ak66666/ThumbsUpV13_Omron/Photos/rev.0/IMG_20260822_193503417.jpg

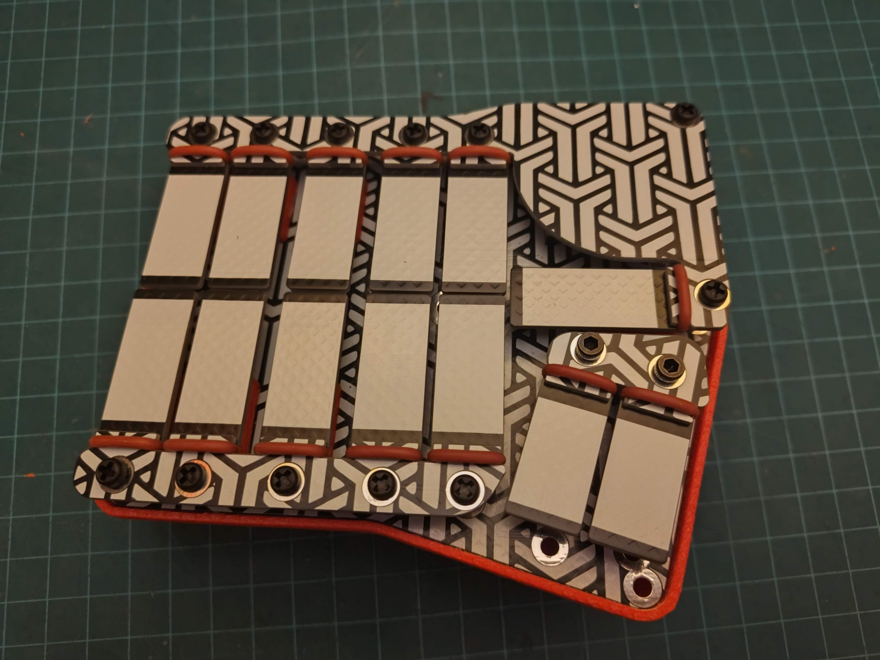
Photos/rev.0/IMG_20260822_193503417.jpg
