ak66666/ThumbsUpV13_Omron/Photos/rev.0/IMG_20260822_193524192_HDR.jpg

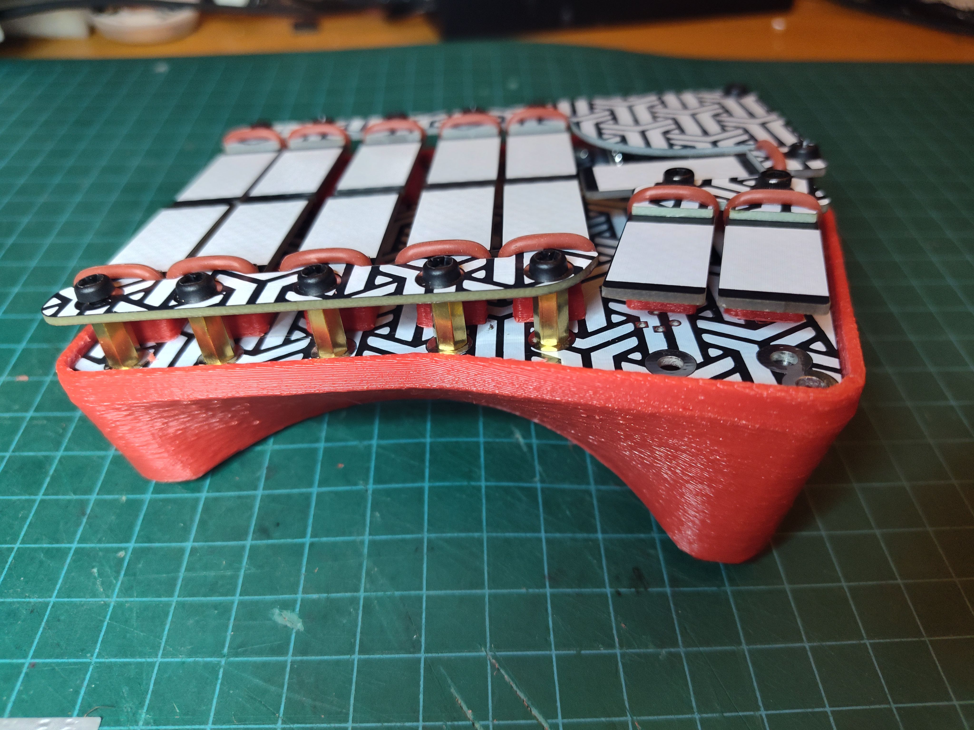
Photos/rev.0/IMG_20260822_193524192_HDR.jpg
