ak66666/ThumbsUpV13_Omron/Photos/rev.0/IMG_20260822_193620206.jpg

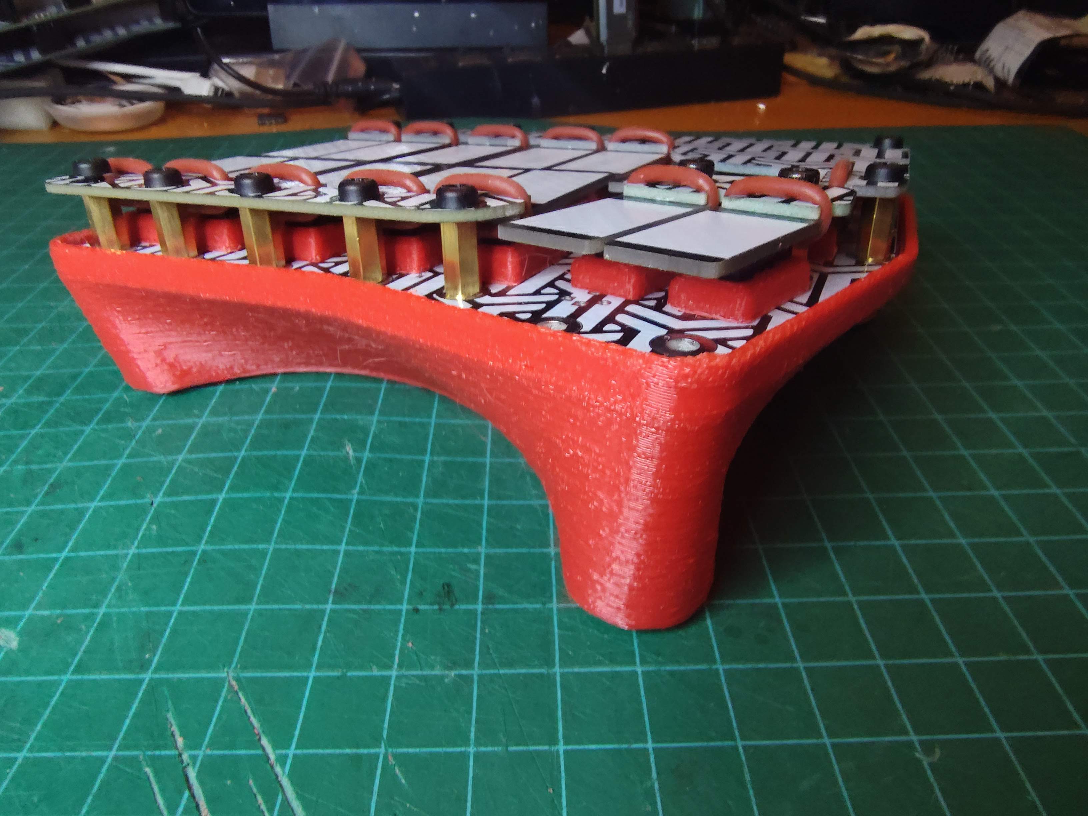
Photos/rev.0/IMG_20260822_193620206.jpg
