ak66666/ThumbsUpV13_Omron/Photos/rev.0/IMG_20260822_220550309_HDR.jpg

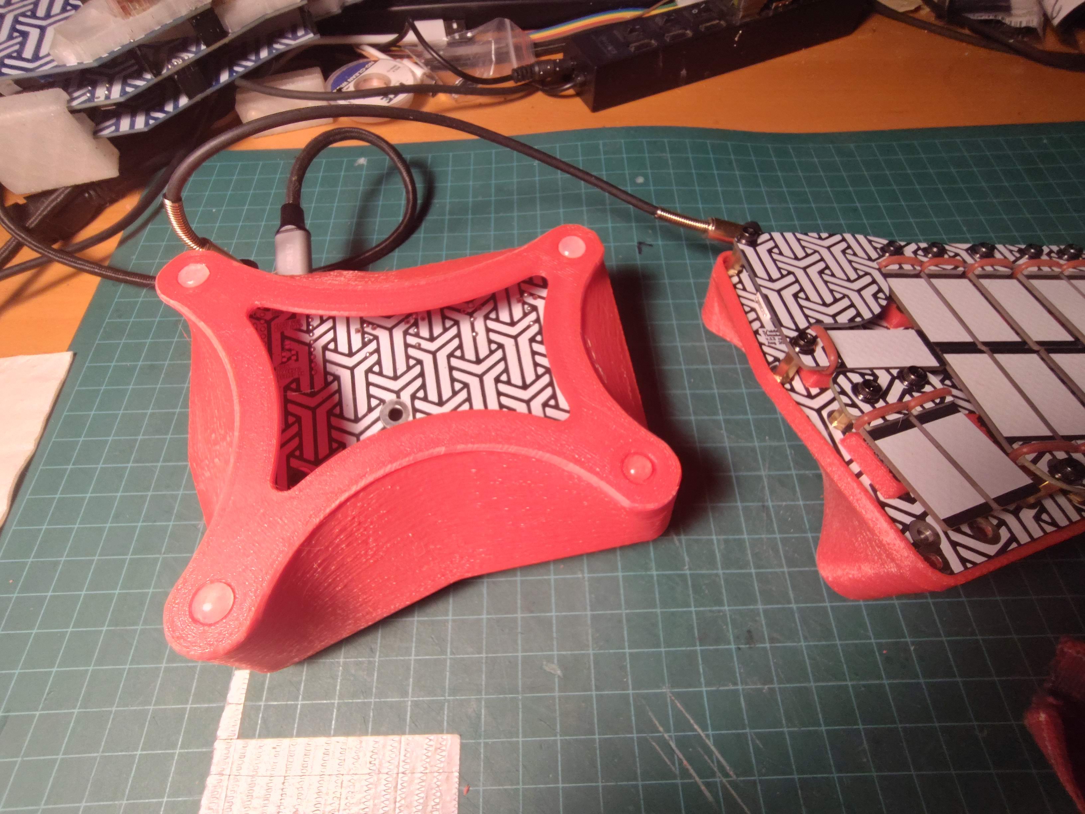
Photos/rev.0/IMG_20260822_220550309_HDR.jpg
