ak66666/ThumbsUpV13_Omron/Silkscreens/Pattern.png

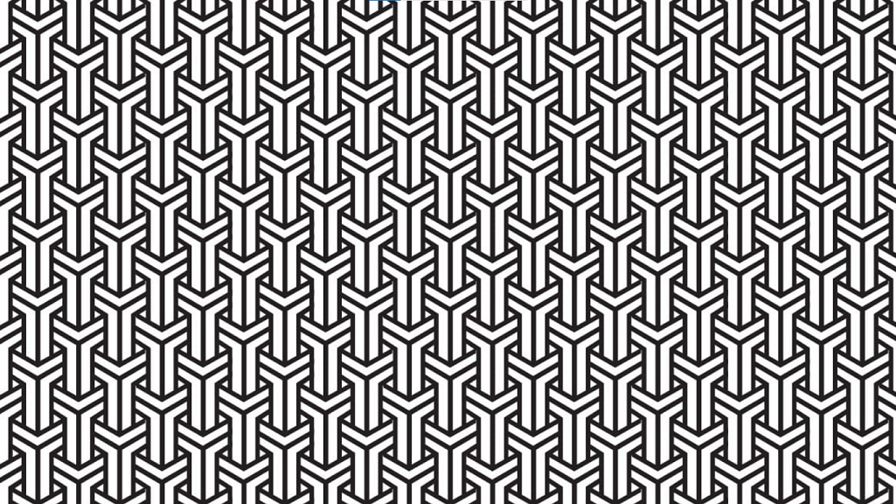
Silkscreens/Pattern.png
