ak66666/ThumbsUpV13_Omron/Silkscreens/QWERTY.png

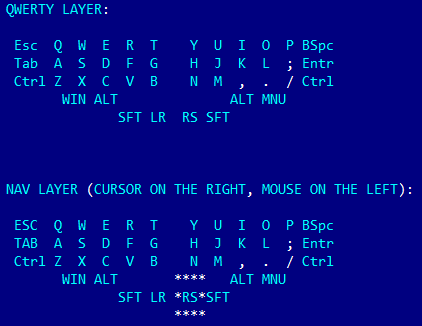
Silkscreens/QWERTY.png
