ak66666/ThumbsUpV13_Omron/3D Printed/Switch Raiser 6x6 Tilted.stl

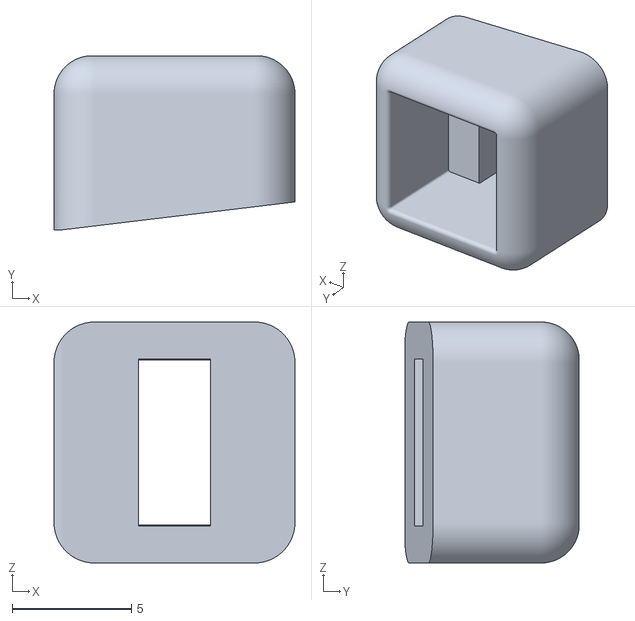
[picture p37: CAD file, 2026-08-06]
3D Printed/Switch Raiser 6x6 Tilted.stl
10.1 x 7.29 x 10.1
