ak66666/ThumbsUpV13_Omron/3D Printed/v13 Rev.0/Case Curvy Right.stl

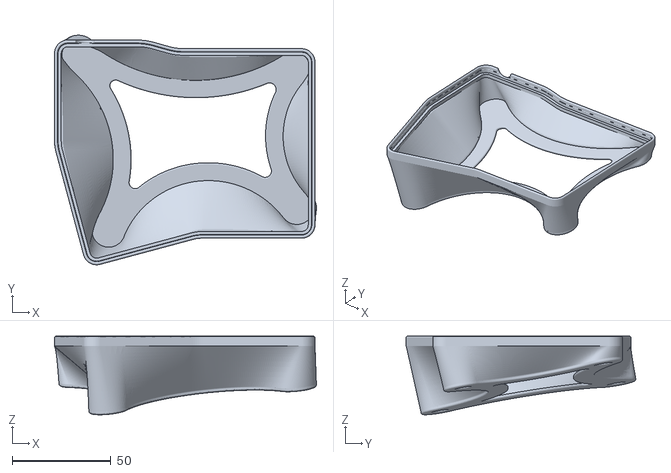
[picture p38: CAD file, 2026-08-23]
3D Printed/v13 Rev.0/Case Curvy Right.stl
132.4 x 116.0 x 39.7
