ak66666/ThumbsUpV13_Omron/STX-3501-3N/3D/STX-3501-3N.stp

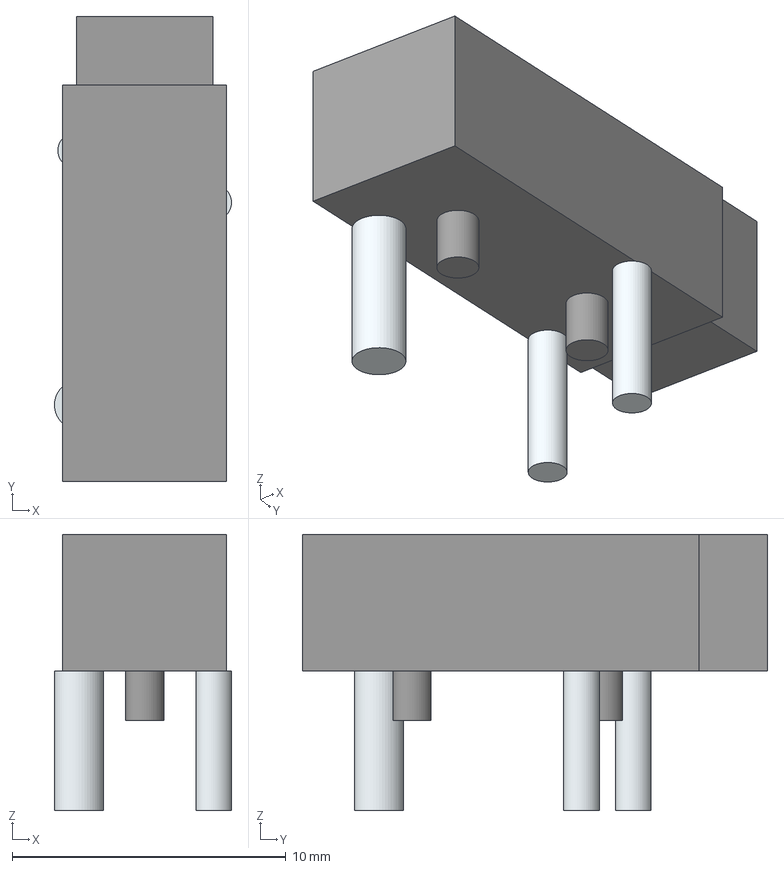
[picture p39: CAD file, 2026-08-06]
STX-3501-3N/3D/STX-3501-3N.stp
6.47 x 17.0 x 10.1 mm
Lugs
Leads
