ak66666/ThumbsUpV13_Omron/W25Q128JVSIM/3D/W25Q128JVSIM.stp

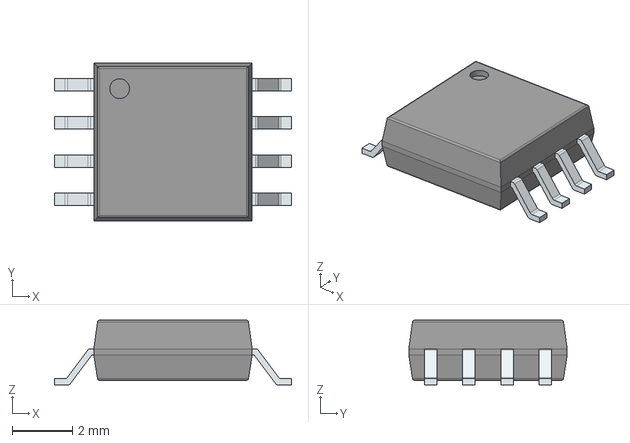
[picture p40: CAD file, 2026-08-06]
W25Q128JVSIM/3D/W25Q128JVSIM.stp
7.90 x 5.28 x 2.16 mm
PinsArrayLR
