ak66666/ThumbsUpV13_Omron/3D Printed/Base.stl

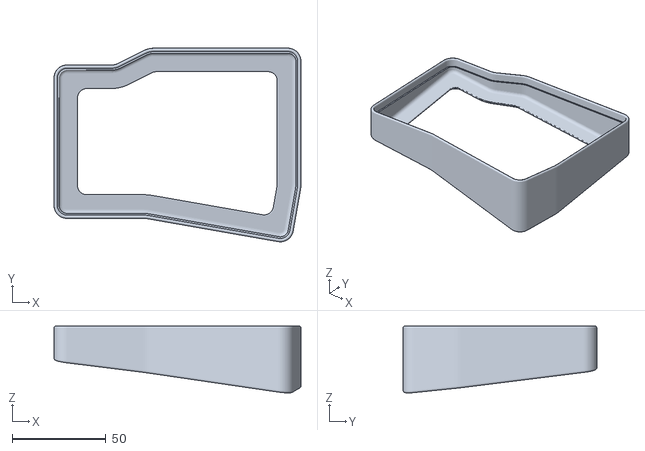
[picture p41: CAD file, 2026-08-06]
3D Printed/Base.stl
132.0 x 103.5 x 35.7
