ak66666/ThumbsUpV13_Omron/3D Printed/v13 Rev.0/Case Straight Right.stl

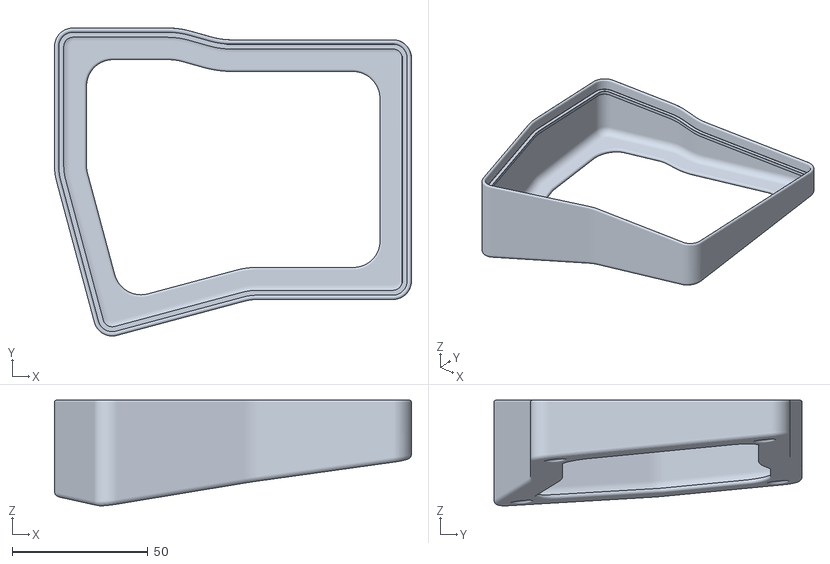
[picture p42: CAD file, 2026-08-22]
3D Printed/v13 Rev.0/Case Straight Right.stl
131.6 x 113.6 x 39.0
