ak66666/ThumbsUpV13_Omron/3D Printed/Switch Raiser Omron Tilted.stl

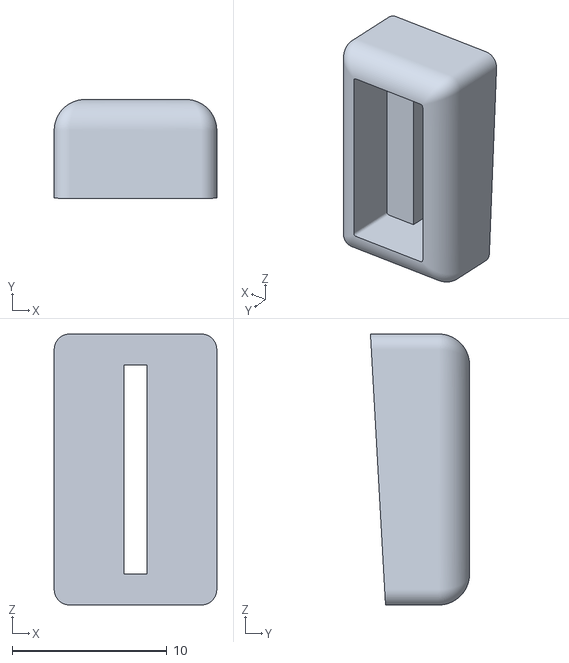
[picture p43: CAD file, 2026-08-06]
3D Printed/Switch Raiser Omron Tilted.stl
10.5 x 6.40 x 17.5
