ak66666/ThumbsUpV13_Omron/3D Printed/v13 Rev.0/Bottom Plate.step

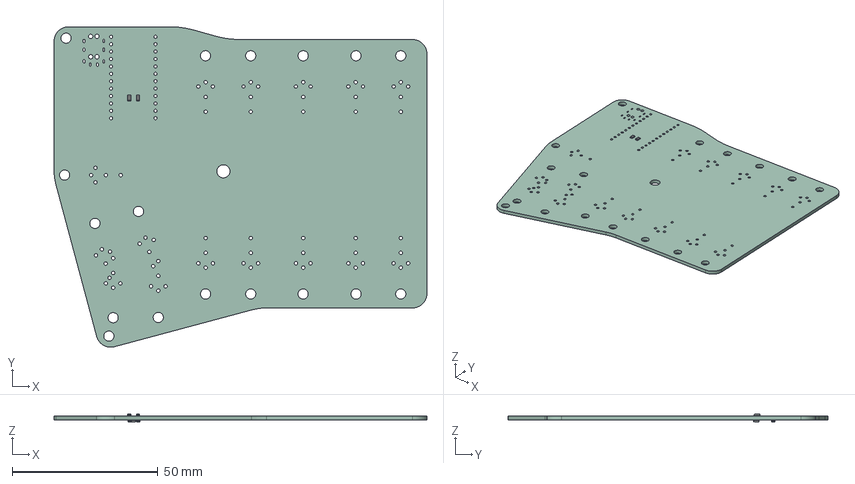
[picture p44: CAD file, 2026-08-22]
3D Printed/v13 Rev.0/Bottom Plate.step
128.0 x 110.0 x 2.58 mm
R_0805_2012Metric x 5
ThumbsUp_PCB
