ak66666/ThumbsUpV13_Omron/3D Printed/Switch Raiser 6x6.stl

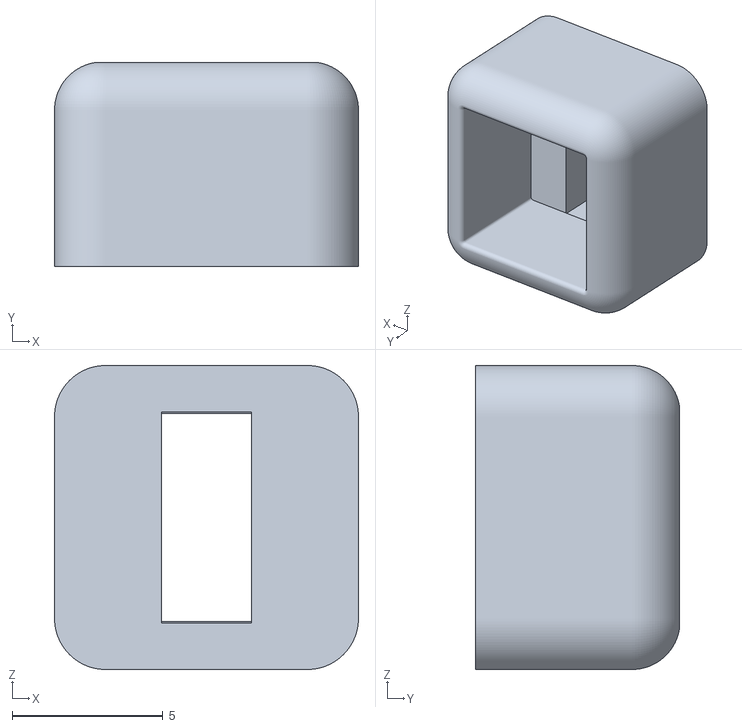
[picture p45: CAD file, 2026-08-06]
3D Printed/Switch Raiser 6x6.stl
10.1 x 6.79 x 10.1
