ak66666/ThumbsUpV13_Omron/3D Printed/v13 Rev.0/Heel Left.stl

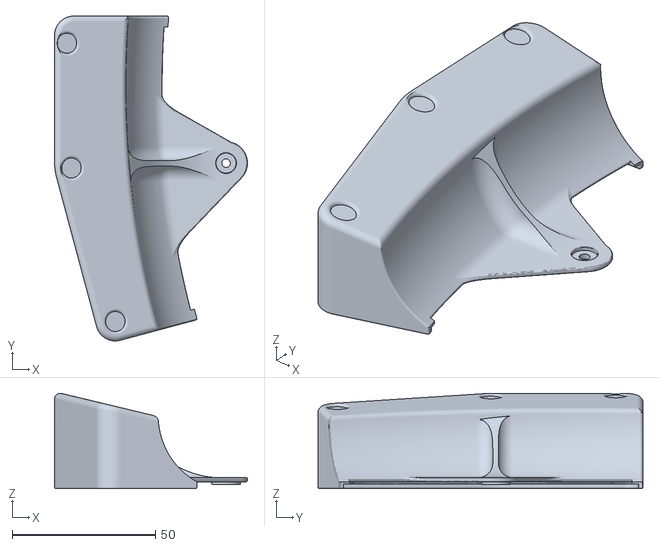
[picture p46: CAD file, 2026-08-06]
3D Printed/v13 Rev.0/Heel Left.stl
67.5 x 113.6 x 33.4
