ak66666/ThumbsUpV13_Omron/105450-0101/3D/105450-0101.stp

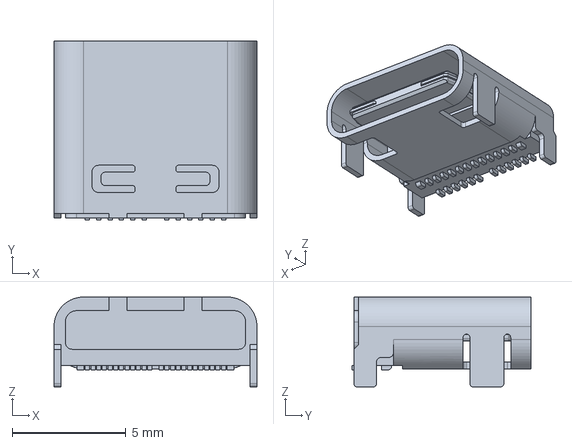
[picture p47: CAD file, 2026-08-06]
105450-0101/3D/105450-0101.stp
8.94 x 7.90 x 3.96 mm
