ak66666/ThumbsUpV13_Omron/Molex 52559-1233/52559-1233/3D/52559-1233.stp

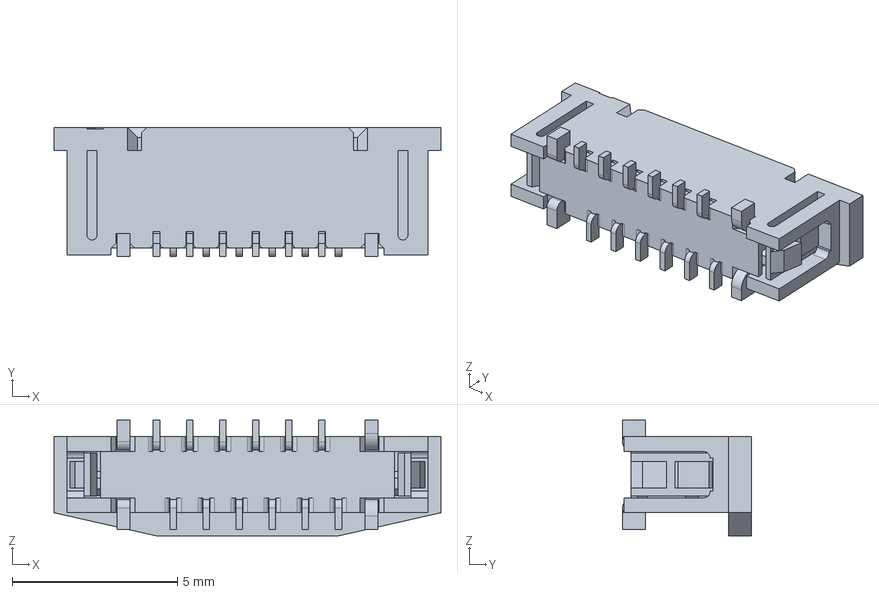
[picture p48: CAD file, 2026-08-06]
Molex 52559-1233/52559-1233/3D/52559-1233.stp
11.7 x 3.90 x 3.50 mm
