ak66666/ThumbsUpV13_Omron/(list of files, cad)

Other CAD files:
EVQ-P7B01P/Allegro/evqp7b01p.psm
EVQ-P7B01P/DEHDL/evq_p7b01p/chips/chips.prt
Molex 52559-1233/52559-1233/Allegro/525591233.psm
Molex 52559-1233/52559-1233/DEHDL/52559_1233/chips/chips.prt
STX-3501-3N/Allegro/stx35013n.psm
STX-3501-3N/DEHDL/stx_3501_3n/chips/chips.prt
TL1016AAF220QG/Allegro/tl1016aaf220qg.psm
TL1016AAF220QG/DEHDL/tl1016aaf220qg/chips/chips.prt
W25Q128JVSIM/Allegro/soic127p790x216-8n.psm
W25Q128JVSIM/DEHDL/w25q128jvsim/chips/chips.prt
