ak66666/ThumbsUpV13_Omron/(list of files, drawings)

Other design files:
EVQ-P7B01P/Altium/EVQ-P7B01P.SchLib
EVQ-P7B01P/Altium/EVQP7B01P.PcbLib
STX-3501-3N/Altium/STX35013N.PcbLib
STX-3501-3N/Altium/STX-3501-3N.SchLib
TL1016AAF220QG/Altium/TL1016AAF220QG.PcbLib
TL1016AAF220QG/Altium/TL1016AAF220QG.SchLib
W25Q128JVSIM/Altium/SOIC127P790X216-8N.PcbLib
W25Q128JVSIM/Altium/W25Q128JVSIM.SchLib
