ak66666/ThumbsUpV13_Omron/ThumbsUp.kicad_pcb

## KiCad design ThumbsUp.kicad_pcb (2026-11-06)

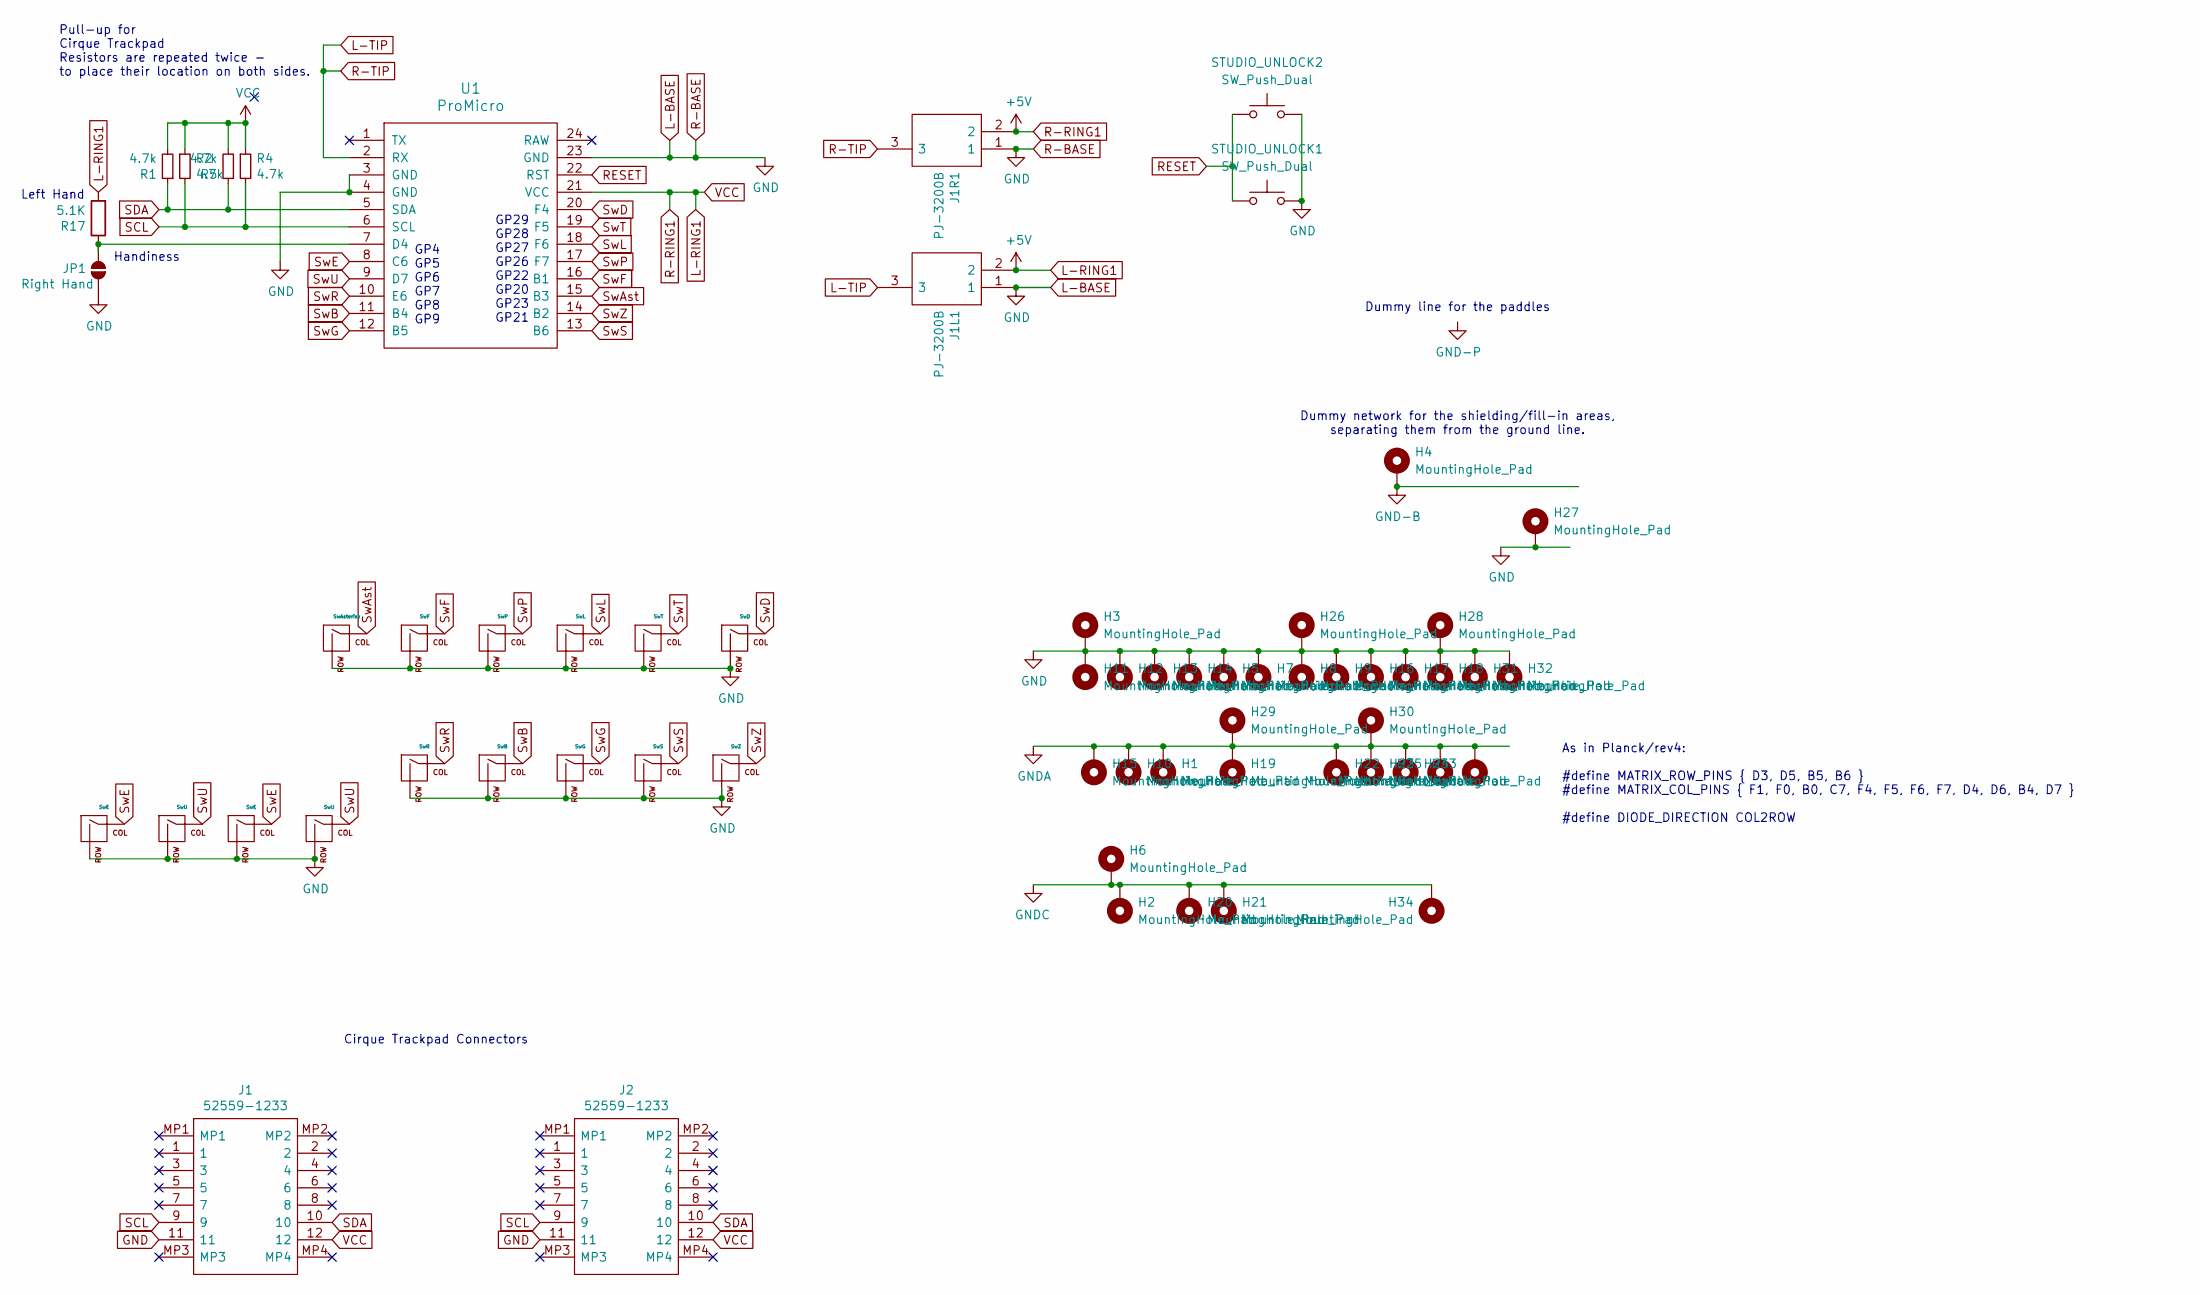
[picture p49: schematic ThumbsUp.kicad_sch]

Parts:
H1, H2, H3, H5, H6, H7, H8, H9, H10, H11, H12, H13, H14, H15, H16, H17, H18, H19, H20, H21, H22, H23, H24, H25, H26, H27, H28, H29, H30, H31, H32, H33, H34: MountingHole_Pad; MountingHole_3.5mm_Pad
H4: MountingHole_Pad; MountingHole_4.5mm_Pad
J1, J2: 52559-1233; 525591233; Mouser Part Number 538-52559-1233
J1L1, J1R1: PJ-3200B; PJ-3200B-4A; Manufacturer_Part_Number STX-3501-3N; Mouser Part Number 806-STX-3501-3N
JP1: Right Hand; SolderJumper-2_P1.3mm_Open_RoundedPad1.0x1.5mm
MX1, MX30: SwE; SW_D2FC_OMR
MX2, MX26: SwU; SW_D2FC_OMR
MX23: SwAsterisk; SW_D2FC_OMR
MX27: SwF; SW_D2FC_OMR
MX28: SwR; SW_D2FC_OMR
MX31: SwP; SW_D2FC_OMR
MX32: SwB; SW_D2FC_OMR
MX35: SwL; SW_D2FC_OMR
MX36: SwG; SW_D2FC_OMR
MX39: SwT; SW_D2FC_OMR
MX40: SwS; SW_D2FC_OMR
MX42: SwD; SW_D2FC_OMR
MX43: SwZ; SW_D2FC_OMR
R1, R2, R4, R5: 4.7k; R_0805_2012Metric
R17: 5.1K; R_0805_2012Metric
STUDIO_UNLOCK1, STUDIO_UNLOCK2: SW_Push_Dual; SW_Push_1P1T_NO_CK_KSC6xxJ
U1: ProMicro; ProMicro-NoSilk

Connections:
GND: H3.1, H5.1, H7.1, H8.1, H9.1, H11.1, H12.1, H13.1, H14.1, H16.1, H17.1, H18.1, H26.1, H27.1, H28.1, H31.1, H32.1, J1.11, J1L1.1, J1R1.1, J2.11, JP1.1 (A), MX1.2 (ROW), MX2.2 (ROW), MX23.2 (ROW), MX26.2 (ROW), MX27.2 (ROW), MX28.2 (ROW), MX30.2 (ROW), MX31.2 (ROW), MX32.2 (ROW), MX35.2 (ROW), MX36.2 (ROW), MX39.2 (ROW), MX40.2 (ROW), MX42.2 (ROW), MX43.2 (ROW), STUDIO_UNLOCK1.2, STUDIO_UNLOCK2.2, U1.3 (GND), U1.4 (GND), U1.23 (GND)
GND-B: H4.1
GNDA: H1.1, H10.1, H15.1, H19.1, H22.1, H23.1, H24.1, H25.1, H29.1, H30.1, H33.1
GNDC: H2.1, H6.1, H20.1, H21.1, H34.1
L-RING1: J1.12, J1L1.2, J1R1.2, J2.12, R1.2, R2.1, R4.1, R5.2, R17.2, U1.21 (VCC)
L-TIP: J1L1.3, J1R1.3, U1.2 (RX)
unnamed: JP1.2 (B), R17.1, U1.7 (D4)
RESET: STUDIO_UNLOCK1.1, STUDIO_UNLOCK2.1, U1.22 (RST)
SCL: J1.9, J2.9, R2.2, R4.2, U1.6 (SCL)
SDA: J1.10, J2.10, R1.1, R5.1, U1.5 (SDA)
SwAst: MX23.1 (COL), U1.15 (B3)
SwB: MX32.1 (COL), U1.11 (B4)
SwD: MX42.1 (COL), U1.20 (F4)
SwE: MX1.1 (COL), MX30.1 (COL), U1.8 (C6)
SwF: MX27.1 (COL), U1.16 (B1)
SwG: MX36.1 (COL), U1.12 (B5)
SwL: MX35.1 (COL), U1.18 (F6)
SwP: MX31.1 (COL), U1.17 (F7)
SwR: MX28.1 (COL), U1.10 (E6)
SwS: MX40.1 (COL), U1.13 (B6)
SwT: MX39.1 (COL), U1.19 (F5)
SwU: MX2.1 (COL), MX26.1 (COL), U1.9 (D7)
SwZ: MX43.1 (COL), U1.14 (B2)

Notes on the sheet:
Pull-up for Cirque Trackpad Resistors are repeated twice - to place their location on both sides.
As in Planck/rev4: #define MATRIX_ROW_PINS { D3, D5, B5, B6 } #define MATRIX_COL_PINS { F1, F0, B0, C7, F4, F5, F6, F7, D4, D6, B4, D7 } #define DIODE_DIRECTION COL2ROW
Cirque Trackpad Connectors
GP4 GP5 GP6 GP7 GP8 GP9
GP29 GP28 GP27 GP26 GP22 GP20 GP23 GP21
Left Hand
Dummy line for the paddles
Handiness
Dummy network for the shielding/fill-in areas, separating them from the ground line.

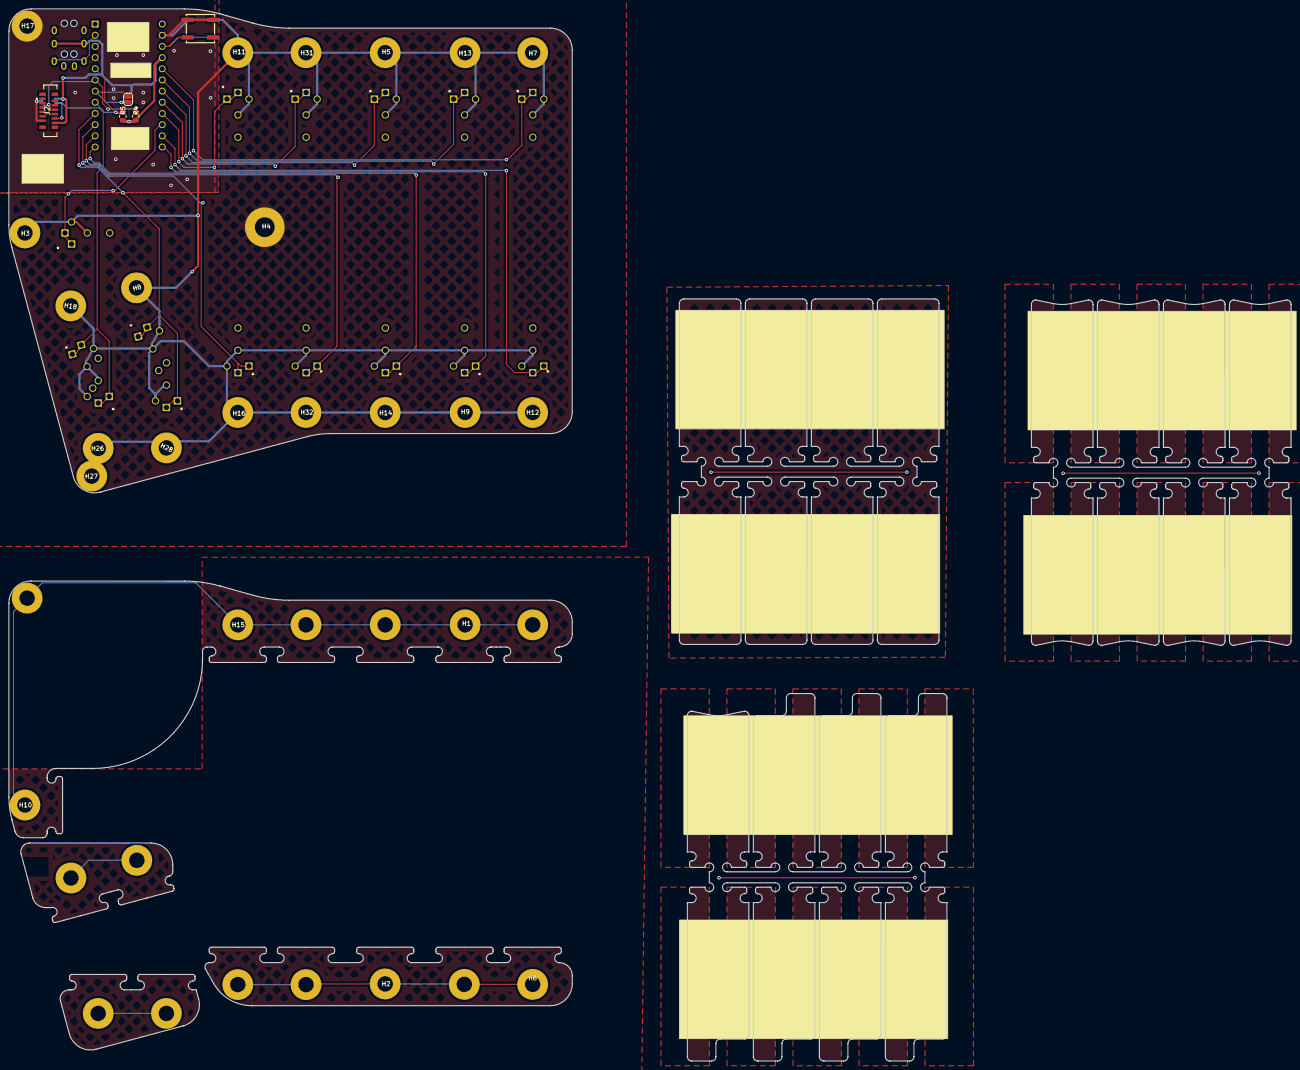
[picture p50: board ThumbsUp.kicad_pcb from above]

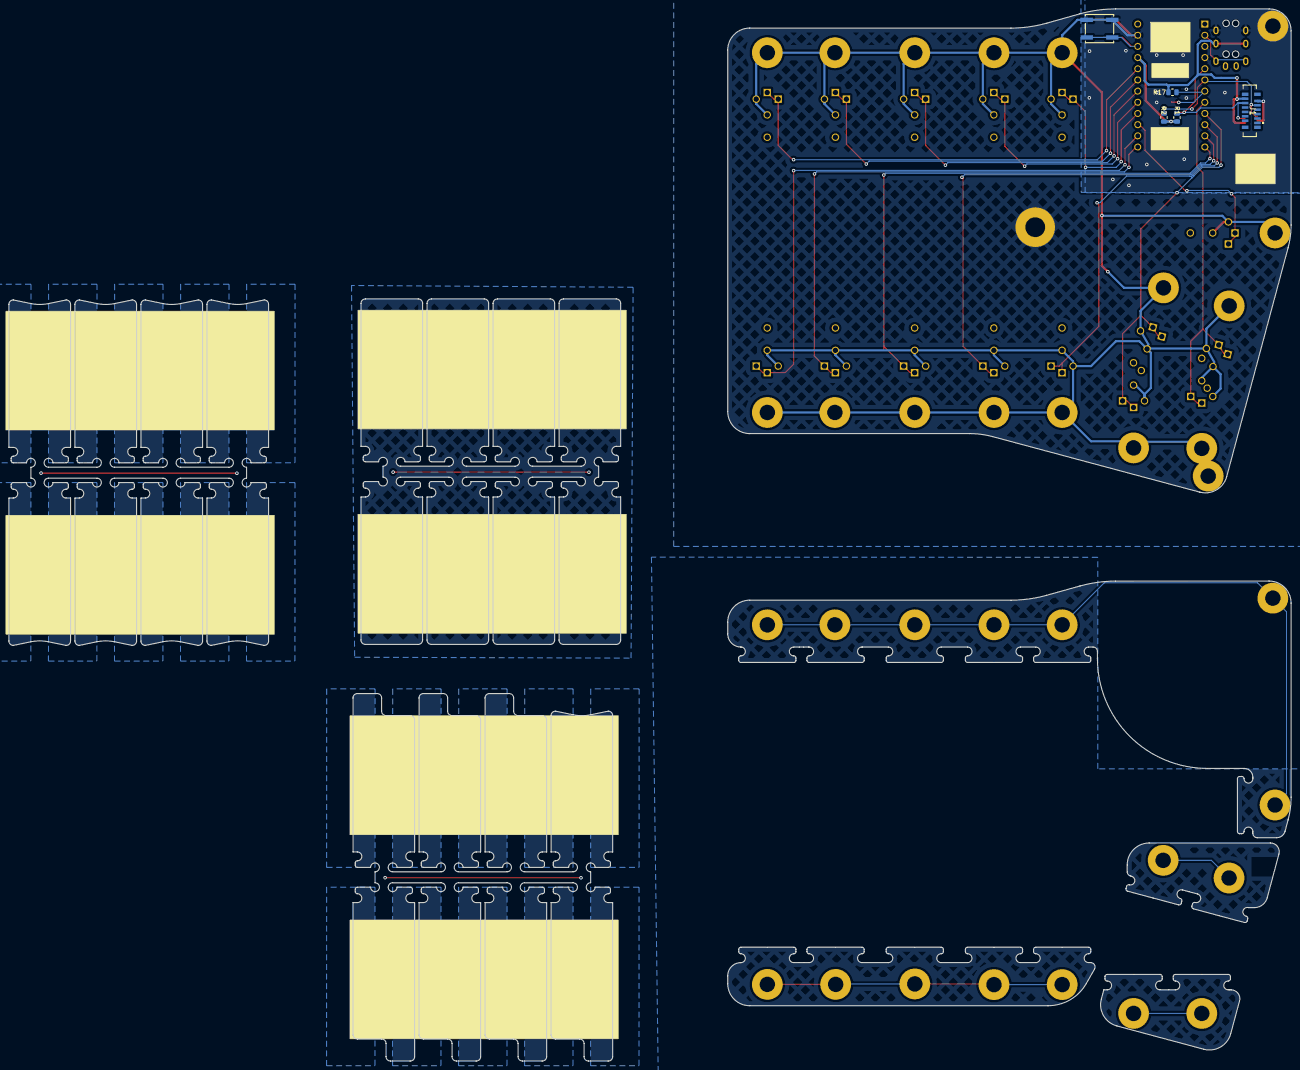
[picture p51: board ThumbsUp.kicad_pcb from below]

Board: 2 copper layers, 291.3 x 239.1 mm, 62 parts (6 on the bottom side), 22 nets.
