ak66666/ThumbsUpV13_Omron/(commit log)

2026-08-06 v13: Initial version.
    [105450-0101.stp, 52559-1233.stp, 525591233.psm, Base rev.3.stl, Base.stl, Bottom Plate rev.3.step, Bottom Plate rev.5.step, Bottom Plate.step]
2026-08-06 v13: Prepared Gerbers for a future order. Added the 3D model for the heel from v12 rev.6, must be compatible.
    [Heel Left.stl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]
2026-08-22 B13: Added 3d model for the drop-in tilted/tented case.
    [Base rev.3.stl, Bottom Plate rev.3.step, Bottom Plate rev.5.step, Bottom Plate.step, Case Curvy Right.stl, Hip Base rev.3.stl, v12 rev5 Heel Left.stl]
2026-08-22 B13: Added board retaining ridge to the curvy model.
    [Case Curvy Right.stl]
2026-08-22 B13: Polishing the curvy model a bit more.
    [Case Curvy Right.stl]
2026-10-23 K12: Added overlapping key flaps, as ordered 20261022.
    [ThumbsUp-B_Cu.gbr, ThumbsUp-B_Mask.gbr, ThumbsUp-B_Paste.gbr, ThumbsUp-B_Silkscreen.gbr, ThumbsUp-Edge_Cuts.gbr, ThumbsUp-F_Cu.gbr, ThumbsUp-F_Mask.gbr, ThumbsUp-F_Paste.gbr]
2026-11-06 K13: Added different shape of the paddles with wider gap between the keys and that hole should be easierto keep the fingers at.
    [ThumbsUp.kicad_pcb]
